igcf126/AnodizingMachine/(list of files, cad)

Other CAD files:
taza.ply
